Emajack512/drone-control-numerical-simulation/hardware/power_distribution_board/03_PDB_PCB_3D_render_.png

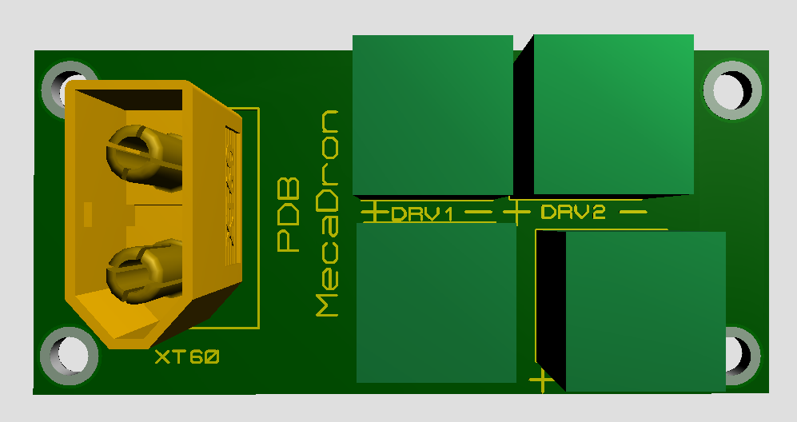
hardware/power_distribution_board/03_PDB_PCB_3D_render_.png
