Emajack512/drone-control-numerical-simulation/media/01_DRON.jpeg

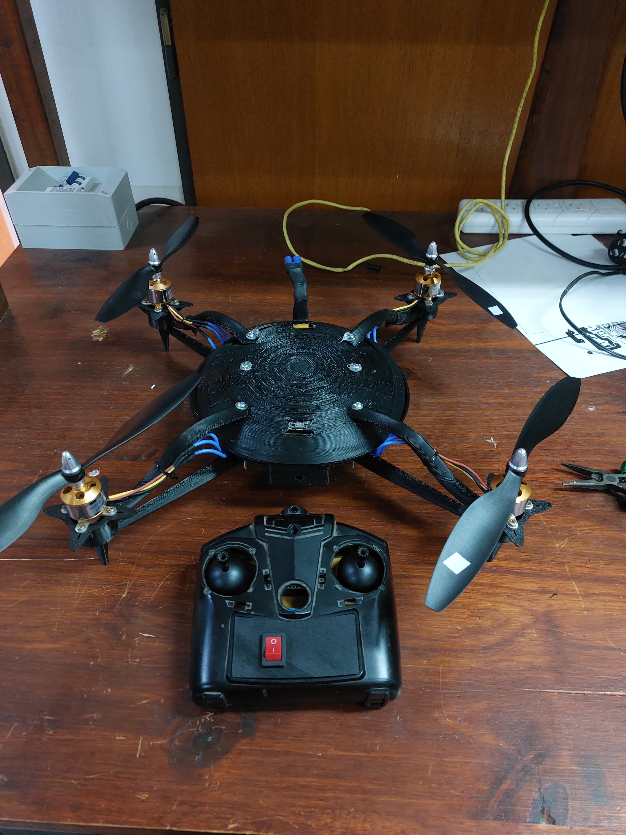
media/01_DRON.jpeg
