Emajack512/drone-control-numerical-simulation/firmware/simulation_matlab/README.md

# Drone Control — MATLAB Simulation

This folder contains the MATLAB code used for multirotor control and numerical simulation.

## Quick start (recommended)
1. Open MATLAB
2. Set the **current folder** to this directory: `firmware/simulation_matlab/`
3. Run:

```matlab
run("main/simulacion_dron_main.m")
