Emajack512/drone-control-numerical-simulation/hardware/flight_controller/01_Flight_controller_schematic.png

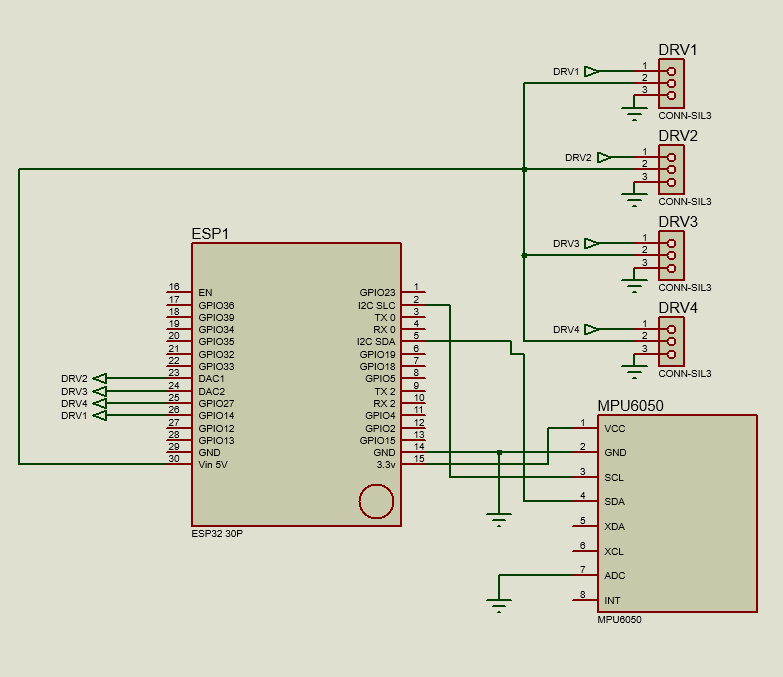
hardware/flight_controller/01_Flight_controller_schematic.png
