Emajack512/drone-control-numerical-simulation/hardware/flight_controller/02_Flight_controller_rounting.png

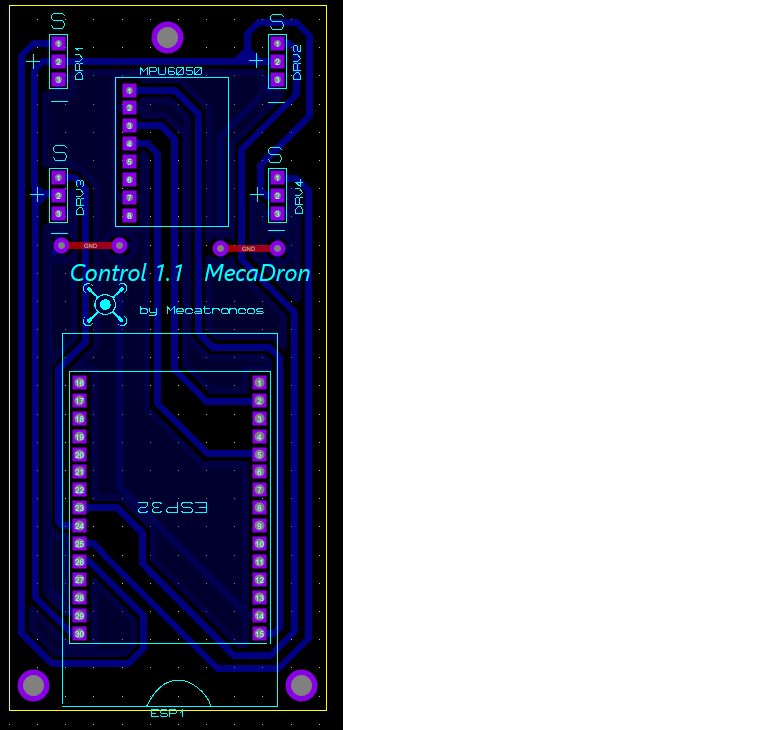
hardware/flight_controller/02_Flight_controller_rounting.png
