Emajack512/drone-control-numerical-simulation/hardware/flight_controller/03_Flight_controller_PCB_3D_render_.png

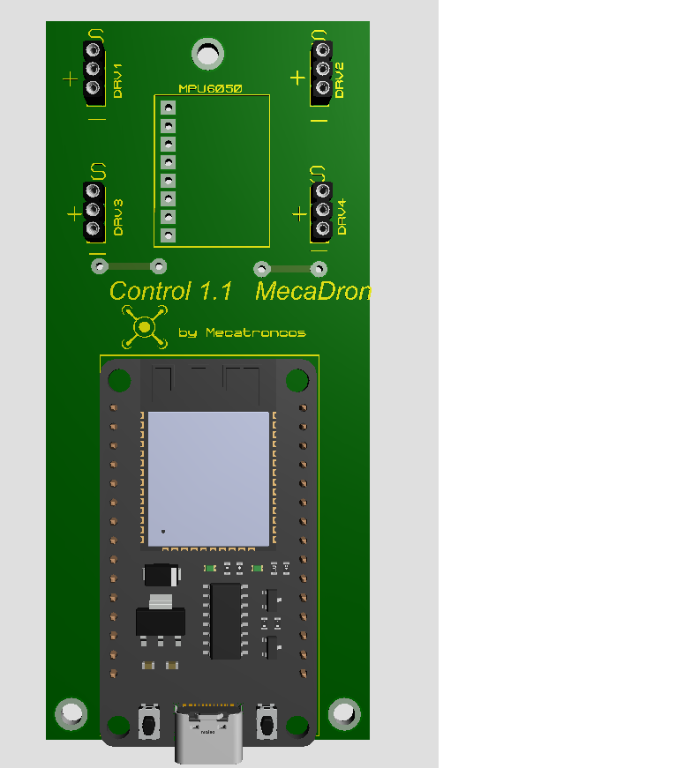
hardware/flight_controller/03_Flight_controller_PCB_3D_render_.png
