Emajack512/drone-control-numerical-simulation/hardware/power_distribution_board/01_PDB_schematic.png

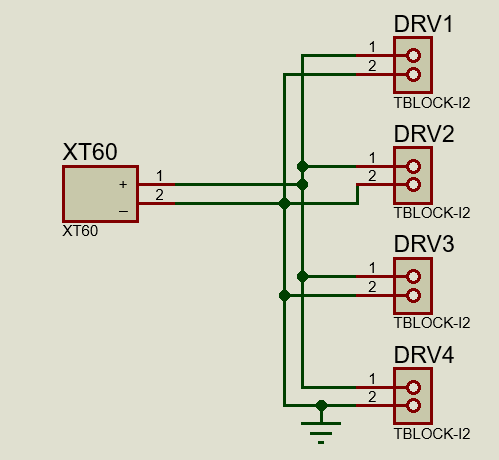
hardware/power_distribution_board/01_PDB_schematic.png
