Emajack512/drone-control-numerical-simulation/hardware/power_distribution_board/02_PDB_routing.png

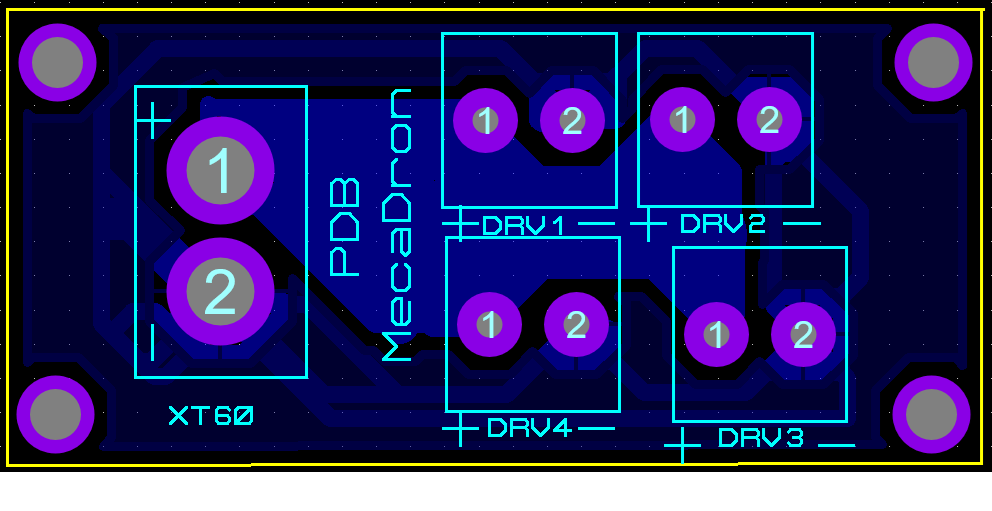
hardware/power_distribution_board/02_PDB_routing.png
