Emajack512/drone-control-numerical-simulation/(list of files, drawings)

Other design files:
hardware/flight_controller/Proteus/Placa Control Dron 1.1.pdsprj
hardware/power_distribution_board/Proteus/PDB DRON.pdsprj
